dennis9819/Tremelo-Effect-Pedal/Front-Panel/rescources/a326120b6ade4debf4655dc24004b7f8.jpg

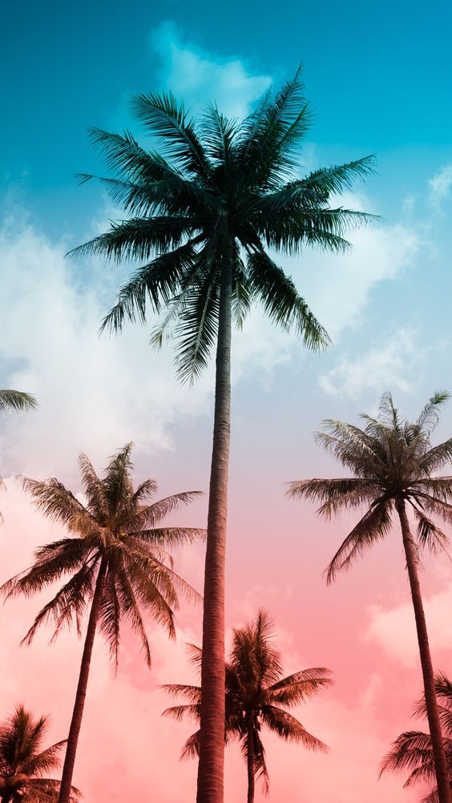
Front-Panel/rescources/a326120b6ade4debf4655dc24004b7f8.jpg
