dennis9819/Tremelo-Effect-Pedal/partlist.md

# Partlist
## Case
* 1x Box Type BB (https://www.musikding.de/Alu-Gehaeuse-Typ-BB)
* 2x 3PDT Footswitch (https://www.musikding.de/3PDT-Fussschalter)
* 1x Carling 1PST Footswitch (https://www.musikding.de/Carling-1PST-Fussschalter)
* 3x LED-Bezel 5mm chrome (https://www.musikding.de/LED-Fassung-5mm-Chrom-Innenreflektor)
* 3x 5mm LED
* 1x Alpha Potentiometer 16mm 50k log (https://www.musikding.de/Alpha-Potentiometer-16mm-50k-log)
* 4x Alpha Potentiometer 16mm 10k lin (https://www.musikding.de/Alpha-Potentiometer-16mm-10k-lin) 25k and 50k is also okay!
* 1x Toggleswitch 1 pole ON-OFF-ON (https://www.musikding.de/Kippschalter-1polig-ON-OFF-ON)
* 2x 6,3mm Mono jack (https://www.musikding.de/63mm-Klinkenbuchse-offen-Mono)

## Circuit
### ICs
* 1x TL072 (https://www.reichelt.de/j-fet-operationsverstaerker-2-fach-16-v-s-4-mhz-dip-8-tl-072-dip-p21556.html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)
* 1x LM13700 (https://www.reichelt.de/transkonduktanzverstaerker-2-fach-dip-16-lm-13700-dil-p10394.html?&trstct=pos_0&nbc=1)
* 1x Attiny (https://www.reichelt.de/8-bit-attiny-avr-risc-mikrocontroller-4-kb-10-mhz-dip-14-attiny-44v-10pu-p119689.html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)
* 1x L7805 (https://www.reichelt.de/spannungsregler-fest-5-v-1-5a-4-to-220-l-7805-cv-p200897.html?&trstct=pos_0&nbc=1)
* 1x 2N4401 (https://www.reichelt.de/bipolartransistor-npn-40v-0-6a-0-25w-to-92-2n-4401-p219074.html?&trstct=pos_0&nbc=1)

### Polarized Capacitor
* 1x 100uF 25V (https://www.reichelt.de/elko-radial-100-uf-25-v-105-c-low-esr-fm-a-100u-25-p200027.html?&trstct=pos_4&nbc=1)
* 5x 1uF (https://www.reichelt.de/elko-radial-1-0-f-250-v-rm-2-5-85-c-2000h-20--m-a-1-0u-250-p199804.html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)
* 1x 47uF 16V (https://www.reichelt.de/elko-radial-47-f-16-v-rm-2-0-85-c-2000h-20--rad-47-16-p15142.html?&trstct=pol_0&nbc=1)

'Capacitors can be replaced by other capacitors with the same capacitance and a minimum voltage rating of 9V. C1,C7,C12 and C14 are part of the signal chain and should be of adequate quality.

### Film Capacitors
* 3x 100nF (https://www.reichelt.de/mks2-pet-kondensator-100-nf-10-63-vdc-rm-5-mks2-63-100n-p12349.html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)
* 1x 330nF (https://www.reichelt.de/mks2-pet-kondensator-330-nf-5-63-vdc-rm-5-mks2-63-330n-p12355.html?&trstct=pol_0&nbc=1)

'Capacitors can be replaced by other capacitors with the same capacitance and a minimum voltage rating of 9V

### Resistors
* 1x 220R 5%
* 2x 1k 1%
* 2x 2k2 1%
* 1x 4k7 1%
* 2x 10k 5%
* 1x 20k 1%
* 1x 20k TRIM
* 3x 100k 1%
* 1x 120k 1%
* 1x 160k 1%
* 1x 330k 1%
* 1x 1M 1%

### Diode
* 1x 1N5817 (Can be jumpered if required)

## Programming
* 1x ISP Programmer for AVR (https://www.fischl.de/usbasp/)
