dennis9819/Tremelo-Effect-Pedal/Tremelo Schematics.pdf

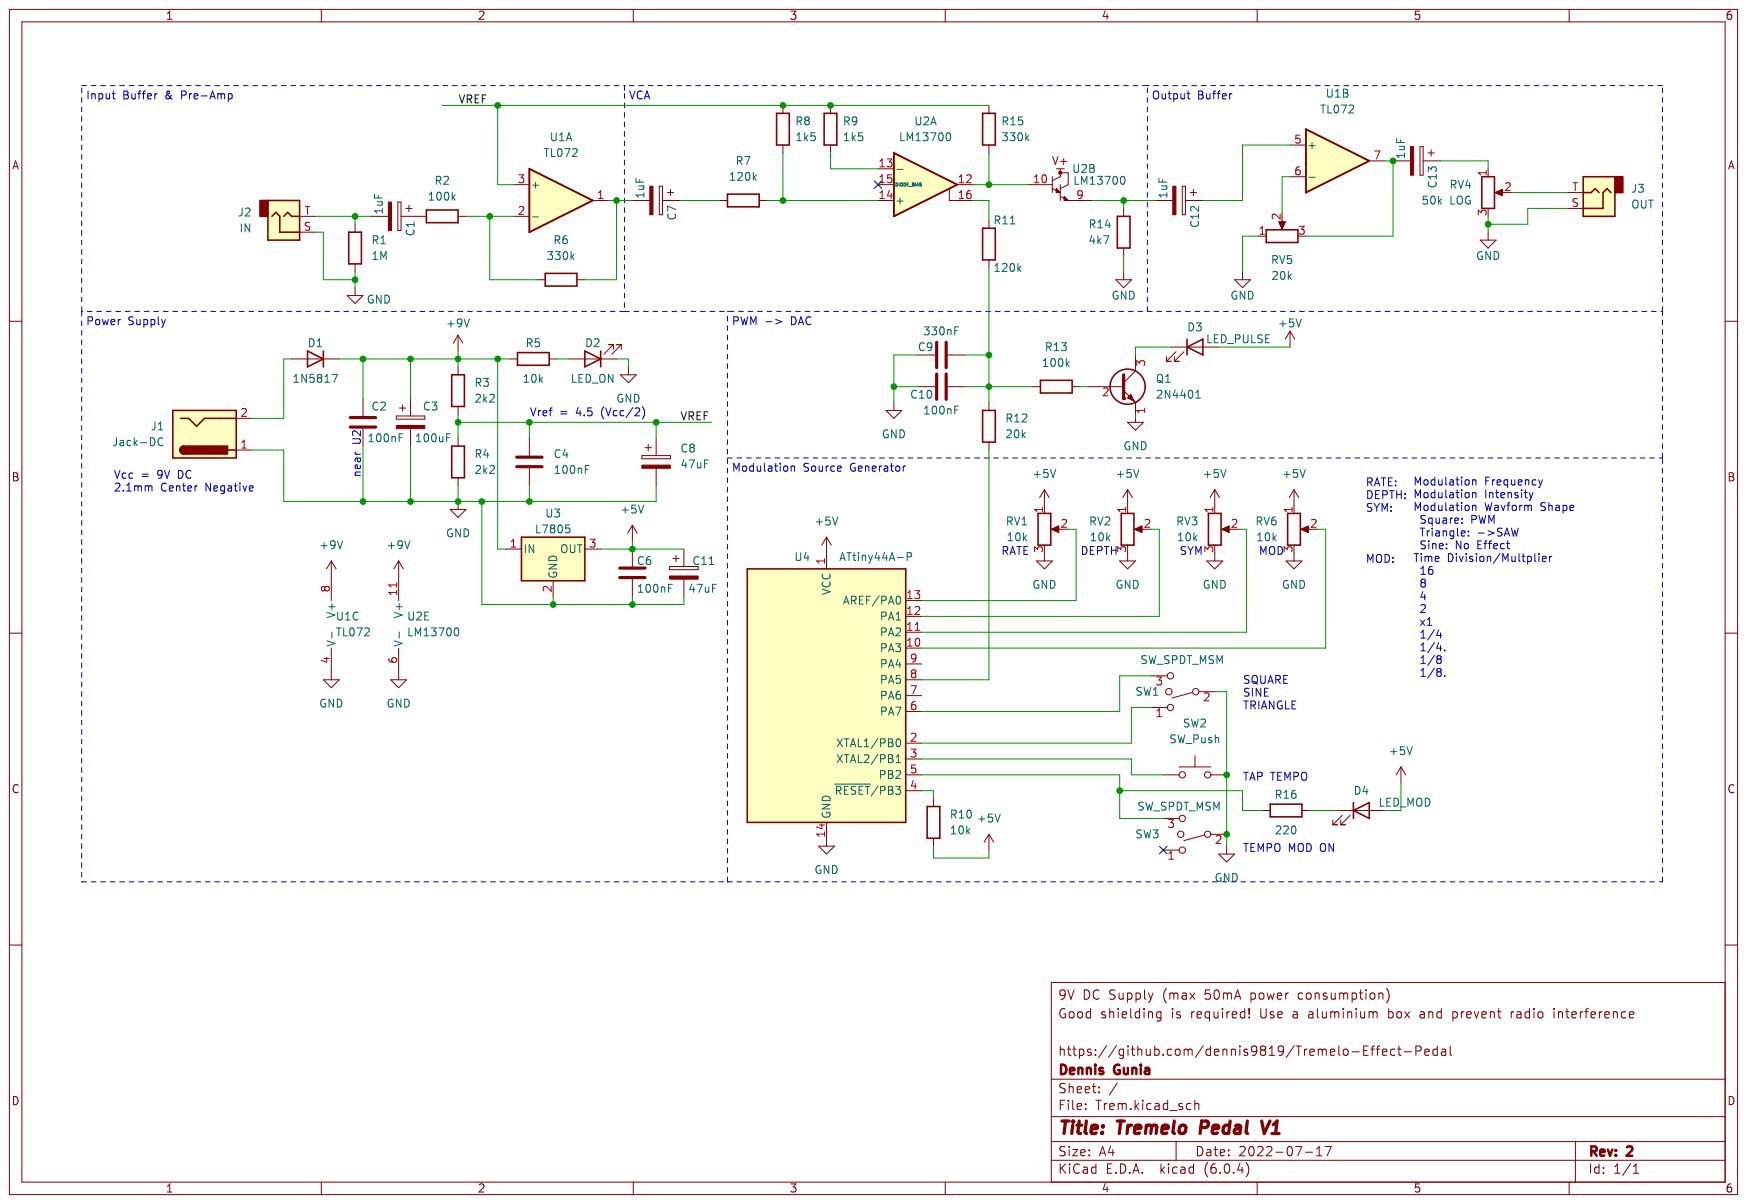
[picture p2: page 1]
