dennis9819/Tremelo-Effect-Pedal/Schematics/Trem.kicad_pcb

## KiCad design Schematics/Trem.kicad_pcb (2022-07-20)

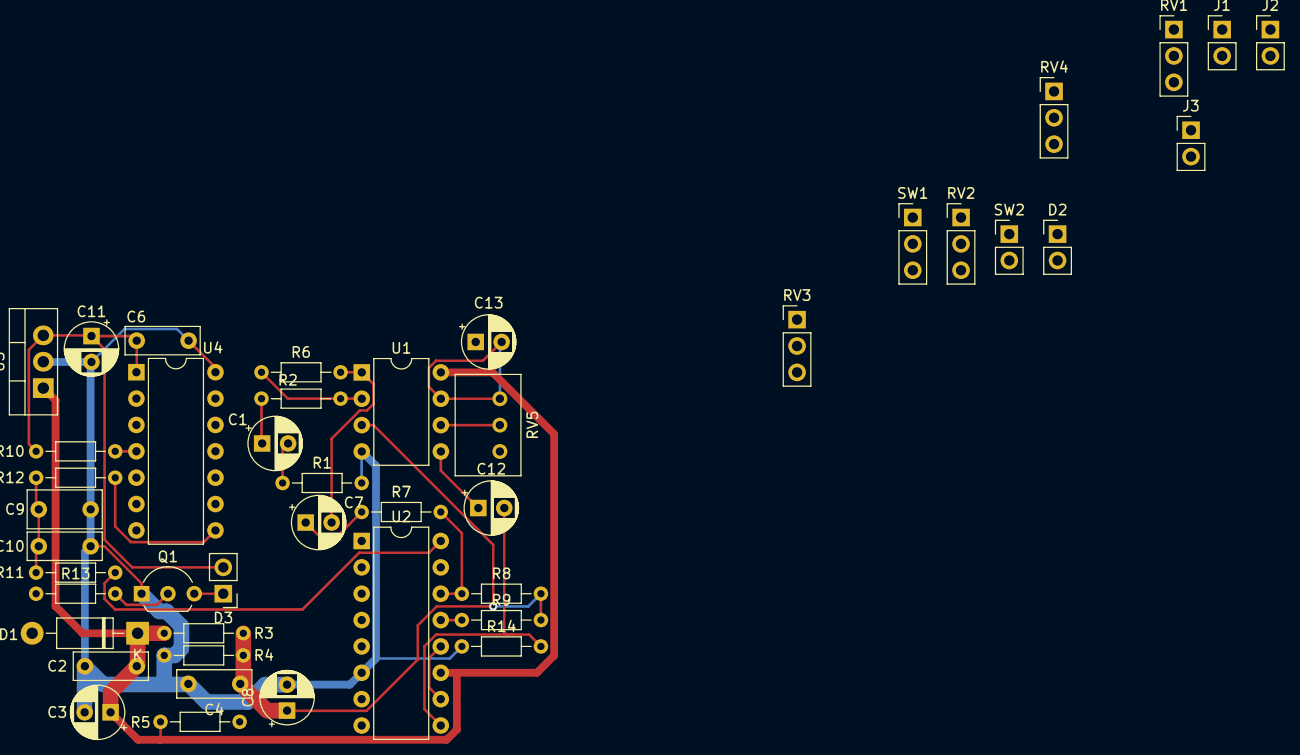
[picture p3: board Trem.kicad_pcb from above]

Board: 2 copper layers, 44 parts (0 on the bottom side), 31 nets.

Parts:
C1, C7, C12, C13: 1uF; CP_Radial_D5.0mm_P2.50mm
C2, C4, C6, C10: 100nF; C_Rect_L7.0mm_W2.5mm_P5.00mm
C3: 100uF; CP_Radial_D5.0mm_P2.50mm
C8, C11: 47uF; CP_Radial_D5.0mm_P2.50mm
C9: 330nF; C_Rect_L7.0mm_W3.5mm_P5.00mm
D1: 1N5817; D_DO-41_SOD81_P10.16mm_Horizontal
D2: LED_ON; PinHeader_1x02_P2.54mm_Vertical
D3: LED_PULSE; PinHeader_1x02_P2.54mm_Vertical
J1: Jack-DC; PinHeader_1x02_P2.54mm_Vertical
J2, J3: AudioJack2; PinHeader_1x02_P2.54mm_Vertical
Q1: 2N4401; TO-92L_Inline_Wide
R1: 1M; R_Axial_DIN0204_L3.6mm_D1.6mm_P7.62mm_Horizontal
R2, R7, R13: 100k; R_Axial_DIN0204_L3.6mm_D1.6mm_P7.62mm_Horizontal
R3, R4: 2k2; R_Axial_DIN0204_L3.6mm_D1.6mm_P7.62mm_Horizontal
R5, R10: 10k; R_Axial_DIN0204_L3.6mm_D1.6mm_P7.62mm_Horizontal
R6: 330k; R_Axial_DIN0204_L3.6mm_D1.6mm_P7.62mm_Horizontal
R8, R9: 1k; R_Axial_DIN0204_L3.6mm_D1.6mm_P7.62mm_Horizontal
R11: 120k; R_Axial_DIN0204_L3.6mm_D1.6mm_P7.62mm_Horizontal
R12: 20k; R_Axial_DIN0204_L3.6mm_D1.6mm_P7.62mm_Horizontal
R14: 4k7; R_Axial_DIN0204_L3.6mm_D1.6mm_P7.62mm_Horizontal
RV1, RV2, RV3: 10k; PinHeader_1x03_P2.54mm_Vertical
RV4: 50k LOG; PinHeader_1x03_P2.54mm_Vertical
RV5: 20k; Potentiometer_Bourns_3299W_Vertical
SW1: SW_SPDT_MSM; PinHeader_1x03_P2.54mm_Vertical
SW2: SW_Push; PinHeader_1x02_P2.54mm_Vertical
U1: TL072; DIP-8_W7.62mm
U2: LM13700; DIP-16_W7.62mm
U3: L7805; TO-220-3_Vertical
U4: ATtiny44A-P; DIP-14_W7.62mm

Connections:
+5V: C6.1, C11.1, D3.2 (A), R10.1, RV1.1, RV2.1, RV3.1, U3.3 (OUT), U4.1 (VCC)
+9V: C2.1, C3.1, D1.1 (K), R3.1, R5.2, U1.8 (V+), U2.11 (V+), U3.1 (IN)
/VREF: C4.1, C8.1, R3.2, R4.1, R8.2, R9.2, U1.3 (+)
GND: C2.2, C3.2, C4.2, C6.2, C8.2, C9.1, C10.1, C11.2, D2.1 (K), J1.1, Q1.1 (E), R1.2, R4.2, R14.1, RV1.3, RV2.3, RV3.3, RV4.3, RV5.1, SW1.2, SW2.2, U1.4 (V-), U2.6 (V-), U3.2 (GND), U4.14 (GND)
unnamed: C1.1, R2.1
unnamed: C1.2, R1.1
unnamed: C7.1, R7.1
unnamed: C7.2, R6.2, U1.1
unnamed: C9.2, C10.2, R11.1, R12.2, R13.1
unnamed: C12.1, U1.5 (+)
unnamed: C12.2, R14.2, U2.9
unnamed: C13.1, RV4.1
unnamed: C13.2, RV5.3, U1.7
unnamed: D1.2 (A), J1.2
unnamed: D2.2 (A), R5.1
unnamed: D3.1 (K), Q1.3 (C)
unnamed: Q1.2 (B), R13.2
unnamed: R2.2, R6.1, U1.2 (-)
unnamed: R7.2, R8.1, U2.14 (+)
unnamed: R9.1, U2.13 (-)
unnamed: R10.2, U4.4 (~RESET/PB3)
unnamed: R11.2, U2.16
unnamed: R12.1, U4.8 (PA5)
unnamed: RV1.2, U4.13 (AREF/PA0)
unnamed: RV2.2, U4.12 (PA1)
unnamed: RV3.2, U4.11 (PA2)
unnamed: RV5.2, U1.6 (-)
unnamed: SW1.1, U4.6 (PA7)
unnamed: SW1.3, U4.10 (PA3)
unnamed: SW2.1, U4.3 (XTAL2/PB1)
unnamed: U2.10, U2.12
